dnotq/nabu/readme.md

# NABU Network Computer

See the repair log.  Maybe there will be more here in the future.  Otherwise, lots of info to be found around the Internet.
