dnotq/nabu/images/led_pcb_bot.jpg

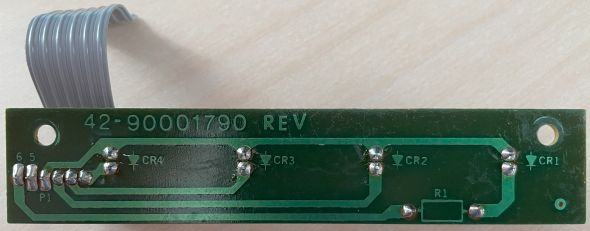
images/led_pcb_bot.jpg
