dnotq/nabu/images/led_pcb_top.jpg

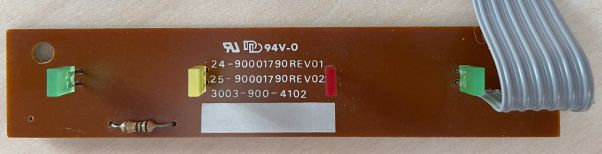
images/led_pcb_top.jpg
