dnotq/nabu/kicad/nabu_led_pcb/nabu_led_pcb.pdf

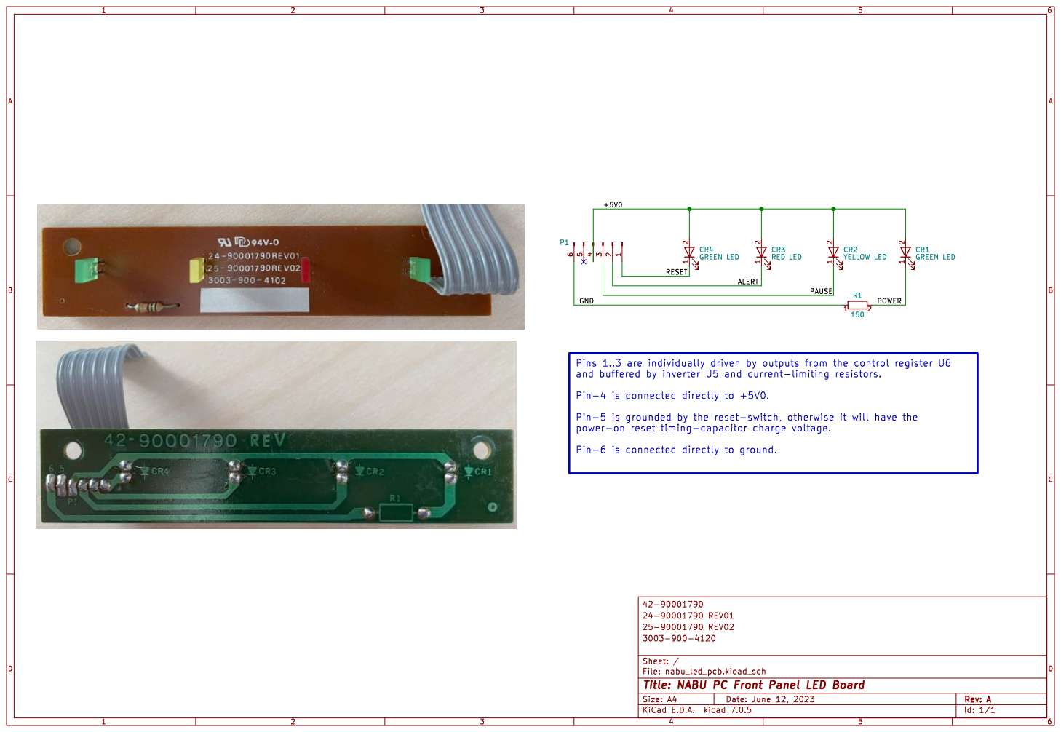
[picture p3: page 1]

Id: 1/1 Title: NABU PC Front Panel LED Board
