dnotq/nabu/kicad/nabu_led_pcb/nabu_led_pcb.kicad_pcb

## KiCad design KiCAD/IEEETechathon2025.kicad_sch

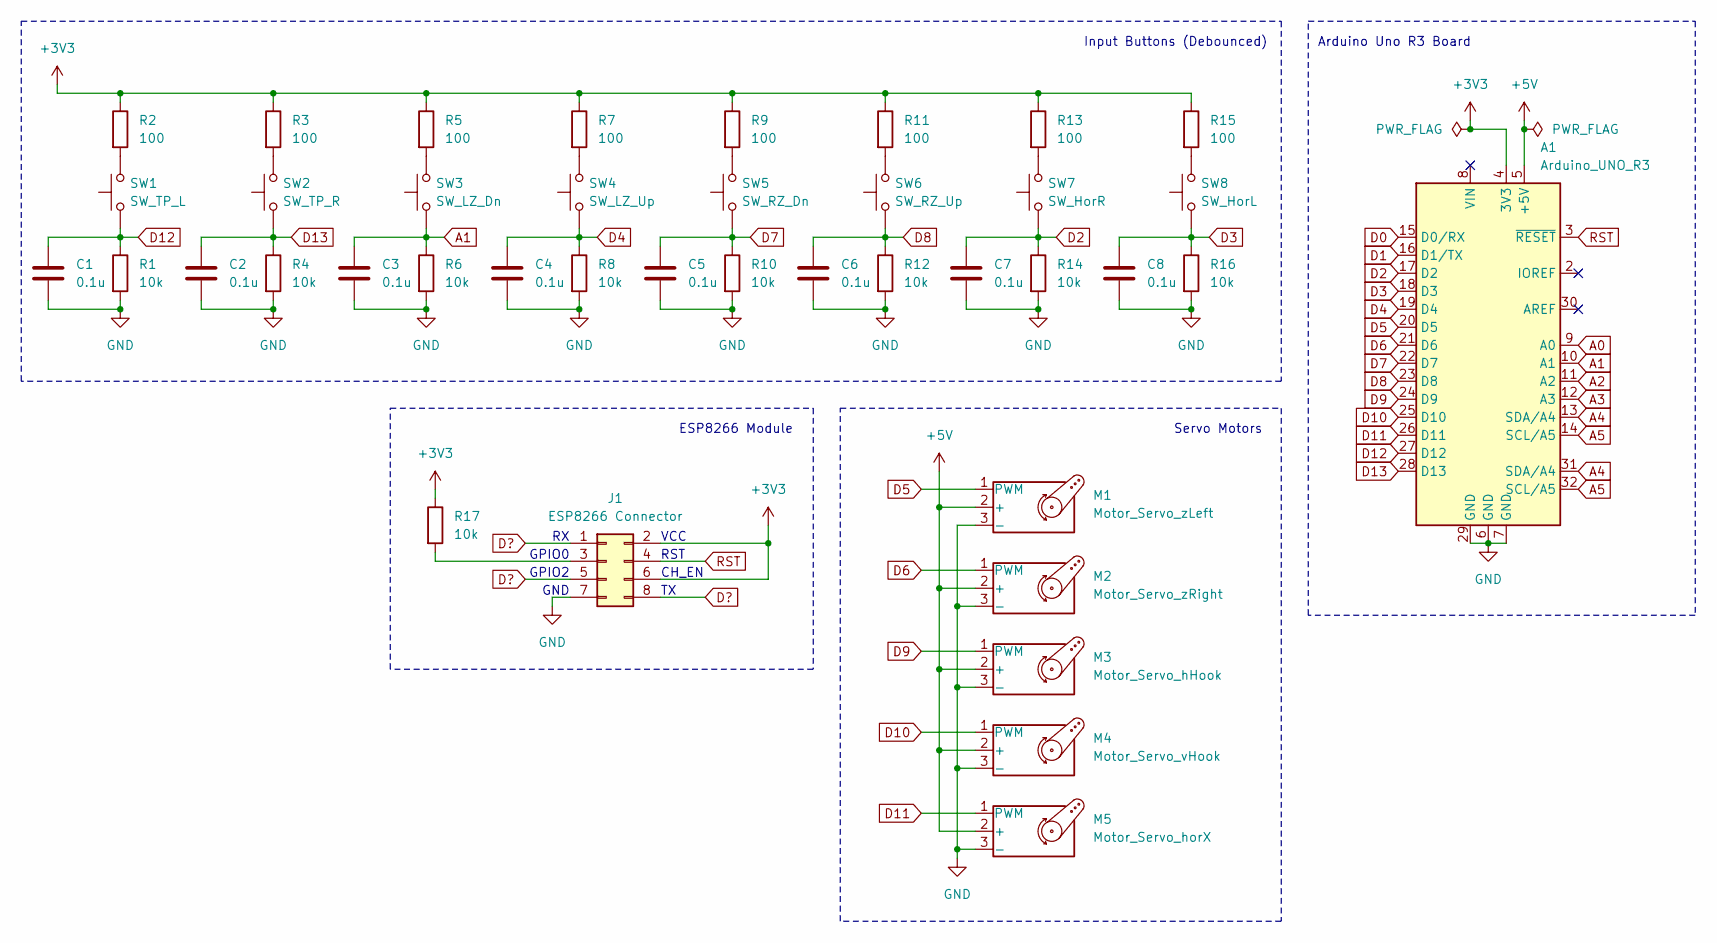
[picture p4: schematic IEEETechathon2025.kicad_sch]

Parts:
A1: Arduino_UNO_R3
C1, C2, C3, C4, C5, C6, C7, C8: 0.1u
J1: ESP8266 Connector
M1: Motor_Servo_zLeft
M2: Motor_Servo_zRight
M3: Motor_Servo_hHook
M4: Motor_Servo_vHook
M5: Motor_Servo_horX
R1, R4, R6, R8, R10, R12, R14, R16, R17: 10k
R2, R3, R5, R7, R9, R11, R13, R15: 100
SW1: SW_TP_L
SW2: SW_TP_R
SW3: SW_LZ_Dn
SW4: SW_LZ_Up
SW5: SW_RZ_Dn
SW6: SW_RZ_Up
SW7: SW_HorR
SW8: SW_HorL

Connections:
+3V3: A1.4 (3V3), J1.2, J1.6, R2.1, R3.1, R5.1, R7.1, R9.1, R11.1, R13.1, R15.1, R17.1
+5V: A1.5 (+5V), M1.2 (+), M2.2 (+), M3.2 (+), M4.2 (+), M5.2 (+)
A0: A1.9 (A0)
A1: A1.10 (A1), C3.1, R6.1, SW3.1
A2: A1.11 (A2)
A3: A1.12 (A3)
A4: A1.13 (SDA/A4), A1.31 (SDA/A4)
A5: A1.14 (SCL/A5), A1.32 (SCL/A5)
D0: A1.15 (D0/RX)
D1: A1.16 (D1/TX)
D2: A1.17 (D2), C7.1, R14.1, SW7.1
D3: A1.18 (D3), C8.1, R16.1, SW8.1
D4: A1.19 (D4), C4.1, R8.1, SW4.1
D5: A1.20 (D5), M1.1 (PWM)
D6: A1.21 (D6), M2.1 (PWM)
D7: A1.22 (D7), C5.1, R10.1, SW5.1
D8: A1.23 (D8), C6.1, R12.1, SW6.1
D9: A1.24 (D9), M3.1 (PWM)
D10: A1.25 (D10), M4.1 (PWM)
D11: A1.26 (D11), M5.1 (PWM)
D12: A1.27 (D12), C1.1, R1.1, SW1.1
D13: A1.28 (D13), C2.1, R4.1, SW2.1
D?: J1.1, J1.5, J1.8
GND: A1.6 (GND), A1.7 (GND), A1.29 (GND), C1.2, C2.2, C3.2, C4.2, C5.2, C6.2, C7.2, C8.2, J1.7, M1.3 (-), M2.3 (-), M3.3 (-), M4.3 (-), M5.3 (-), R1.2, R4.2, R6.2, R8.2, R10.2, R12.2, R14.2, R16.2
unnamed: J1.3, R17.2
unnamed: R2.2, SW1.2
unnamed: R3.2, SW2.2
unnamed: R5.2, SW3.2
unnamed: R7.2, SW4.2
unnamed: R9.2, SW5.2
unnamed: R11.2, SW6.2
unnamed: R13.2, SW7.2
unnamed: R15.2, SW8.2
RST: A1.3 (~RESET), J1.4

Notes on the sheet:
Input Buttons (Debounced)
RST
CH_EN
ESP8266 Module
GND
Servo Motors
VCC
GPIO0
Arduino Uno R3 Board
GPIO2
