dnotq/nabu/(commit log)

2023-06-12 Added schematic for LED PCB.
    [nabu_led_pcb.kicad_pcb, nabu_led_pcb.kicad_sch]
2023-06-12 Updated to latest KiCAD.
    [nabu_led_pcb.kicad_sch]
